LunaQu4kez/SUSTech_CS202_MineCPU/code/vivado_project/vivado_project.runs/progrom_synth_1/.vivado.begin.rst

<?xml version="1.0"?>
<ProcessHandle Version="1" Minor="0">
    <Process Command="vivado.bat" Owner="Kurumi" Host="LAPTOP-1890NNVV" Pid="9872">
    </Process>
</ProcessHandle>
