LunaQu4kez/SUSTech_CS202_MineCPU/program/testcase/testcase2.txt

0000000003af410113000000e30c0ffe83a581009304000063809504930410006388950693042000638e950e9304300063889516930440006384952093045000638e95229304600063849526930470006386952e6ff01ffb03a60100930200006308060013561600938212006ff05fff1303800063880200b302534023a651006ff05ff89302700023a651006ff09ff723a6010023a8010003a6010083a64100138306009373360093938300330373009373c60793d323001303034093070008337ef600930f9001b38e7f4063d40e02b38ef341331fd3016f00400063080e00330fe04123a4e1036ff0dff123a4e1036ff05ff1335fd301930f0002b38edf413313d301e30c03fc63080e00330fe04123a4e1036ff01fef130f1f0023a4e1036ff05fee23a6010023a8010003a6010083a64100138306009373360093938300330373009373c60793d323001303034093070008337ef600930f9001b38e7f4063d80e00b38ef341331fd3016ff01ff7335fd301930f0002b38edf413313d301e30e03f4630a0e00130f1f00330fe04123a4e1036ff01fe723a4e1036ff09fe623a6010023a8010003a6010083a64100138306009373360093938300330373009373c60793d323001303034093070008337ef600930f9001b38e7f4063d80e00b38ef341331fd3016ff05fef335fd301930f0002b384df4133149300e30004ee930f1000938efeffb39fdf013379f301938e1e00630409006f004001e30e0ef6330fe04123a4e1036ff0dfdde3060eee130f1f00330fe04123a4e1036ff09fdc23a6010023a8010003a6010083a641003303d60093538300130ef00f3373c30163860300330373006f0040003343c30123a6610023a461026ff0dfd823a6010023a8010003a6010083a641001303f000b373c30093968600b3837600371300001303f3ffb373730023a471026ff09fd523a6010023a8010003a60100130f0000930f000093850f00ef004001938f1f00e3cac5fe23a4e1036ff0dfd2130141ff232211002320b100130f2f0093a2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
