LunaQu4kez/SUSTech_CS202_MineCPU/program/testcase/testcase1.txt

00000000930e0000371e0010130e0e0003af4101e30edfff83a5810003a6010083a6410093040000638095049304100063829504930420006388950493043000638e95049304400063829506930450006386950693046000638a950693047000638e95066ff0dffa23a6c10023a8d1006ff01ffa0385010093083000730000002320ae006f00400703c5410093083000730000002322ae006f00000603230e0083234e00630473046f00000503230e0083234e00634c73026f00000403230e0083234e00635473026f00000303230e0083234e00636c73006f00000203230e0083234e00637473006f000001930f000c23a6f1016ff0dff1930f000023a6f1016ff01ff100000000000000000000000000000000000000000000000000000000000000000000000000000000000000000000000000000000000000000000000000000000000000000000000000000000000000000000000000000000000000000000000000000000000000000000000000000000000000000000000000000000000000000000000000000000000000000000000000000000000000000000000000000000000000000000000000000000000000000000000000000000000000000000000000000000000000000000000000000000000000000000000000000000000000000000000000000000000000000000000000000000000000000000000000000000000000000000000000000000000000000000000000000000000000000000000000000000000000000000000000000000000000000000000000000000000000000000000000000000000000000000000000000000000000000000000000000000000000000000000000000000000000000000000000000000000000000000000000000000000000000000000000000000000000000000000000000000000000000000000000000000000000000000000000000000000000000000000000000000000000000000000000000000000000000000000000000000000000000000000000000000000000000000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
