LunaQu4kez/SUSTech_CS202_MineCPU/sources/assembly/test_board/small_testcase.txt

00000000 13048000 93021000 03a54101
13000000 63045500 6ff05fff 03a40100
03a58101 13000000 63045500 6ff05fff
83a40100 03a5c101 13000000 63045500
6ff05fff 03a90100 13030000 63086400
13033000 630a6400 6ff0dffa 23a69100
23a82101 6ff01ffa 63862401 23a85100
6f008000 23a65100 6ff0dff8
