LunaQu4kez/SUSTech_CS202_MineCPU/sources/assembly/test_board/button_test.txt

00000000 93821200 03a34101 13000000
63846200 6ff05fff 83a30100 23a67100
6ff09ffe
