LunaQu4kez/SUSTech_CS202_MineCPU/program/my_pacman/main.cpp

#include <bits/stdc++.h>
using namespace std;

void init();
void print_map();
void time_delay();
void stepO();
void stepA();
void stepB();
void stepC();
void stepD();
bool checkover();
void ghost_move(int, int, int);
int bfs(int, int, int);


int game[31][28]; // -1 wall, 0 road, 1 point, 2 pacman, 3 red ghost, 4 pink ghost, 5 blue ghost, 6 orange ghost
int ox, oy;       // pacman x y
int gx[4], gy[4]; // ghost x y: red, pink, blue, orange
int dir;  // direction: 0 up, 1 down, 2 left, 3 right
int st[4];  // step now
int step, score;  
int cnt;  // for time delay
int bx[300], by[300], bh[300], bxt[300], byt[300], bht[300];  // t: temp, x,y: x,y, h: head
int bmap[31][28];
int bi, bit;  // bfs index
int wx, wy;


int main() {
    //while (true) {
        init();
        print_map();
        // if bt1 is pushed, start game
        // while (true) {
        //     if (bt1 is pushed) break;
        // }

        while (true) {
            ///******  for test  ******
            int t;
            cin >> t;
            if (t == 8) dir = 0;
            if (t == 5) dir = 1;
            if (t == 4) dir = 2;
            if (t == 6) dir = 3;
            // ******  for test  ******/
            time_delay();
            stepO();
            stepA();
            stepB();
            stepC();
            stepD();
            print_map();
            if (checkover()) {
                printf("*******************\n");
                printf("*******CAUGHT******\n");
                printf("*******************\n");
                break;
            }
        }

        // if bt1 is pushed, end and start a new game
        // while (true) {
        //     if (bt1 is pushed) break;
        // }
    //}
}

void stepO() {
    step++;
    printf("ox oy: %d %d\n", ox, oy);
    if (dir == 0) {   // up
        if (game[ox - 1][oy] != -1) {
            game[ox][oy] = 0;
            ox--;
            if (game[ox][oy] == 1) score++;
            game[ox][oy] = 2;
        }
    }
    if (dir == 1) {   // down
        if (game[ox + 1][oy] != -1) {
            game[ox][oy] = 0;
            ox++;
            if (game[ox][oy] == 1) score++;
            game[ox][oy] = 2;
        }
    }
    if (dir == 2) {   // left
        if (game[ox][oy - 1] != -1) {
            game[ox][oy] = 0;
            oy--;
            if (game[ox][oy] == 1) score++;
            game[ox][oy] = 2;
        }
    }
    if (dir == 3) {   // right
        if (game[ox][oy + 1] != -1) {
            game[ox][oy] = 0;
            oy++;
            if (game[ox][oy] == 1) score++;
            game[ox][oy] = 2;
        }
    }
}

void ghost_move(int idx, int tx, int ty) {   // ghost index, target point x, target point y
    printf("%d target %d %d\n", idx, tx, ty);
    printf("%d pos %d %d\n", idx, gx[idx], gy[idx]);
    printf("wx wy: %d %d\n", wx, wy);

    if (gx[idx] == tx && gy[idx] == ty) {
        game[tx][ty] = idx + 3;
        return;
    }

    cnt = 0;
    while (cnt < 300) {
        bxt[cnt] = 0;
        byt[cnt] = 0;
        bht[cnt] = 0;
        cnt++;
    }
    cnt = 0;
    int x = gx[idx];
    int y = gy[idx];
    for (int i = 0; i < 31; i++) {
        for (int j = 0; j < 28; j++) {
            bmap[i][j] = 0;
        }
    }
    bmap[x][y] = 1;
    if (idx == 1 || idx == 2) {
        bmap[wx][wy] = 1;
    }
    
    bit = 0;
    if (game[x-1][y] != -1 && bmap[x-1][y] != 1) {  // up
        if (x - 1 == tx && y == ty) {
            gx[idx] = tx;
            gy[idx] = ty;
            game[x][y] = st[idx];
            return;
        }
        bxt[bit] = x - 1;
        byt[bit] = y;
        bht[bit] = 0;
        bmap[x-1][y] = 1;
        bit++;
    }
    if (game[x+1][y] != -1 && bmap[x+1][y] != 1) {  // down
        if (x + 1 == tx && y == ty) {
            gx[idx] = tx;
            gy[idx] = ty;
            game[x][y] = st[idx];
            return;
        }
        bxt[bit] = x + 1;
        byt[bit] = y;
        bht[bit] = 1;
        bmap[x+1][y] = 1;
        bit++;
    }
    if (game[x][y-1] != -1 && bmap[x][y-1] != 1) {  // left
        if (x == tx && y - 1 == ty) {
            gx[idx] = tx;
            gy[idx] = ty;
            game[x][y] = st[idx];
            return;
        }
        bxt[bit] = x;
        byt[bit] = y - 1;
        bht[bit] = 2;
        bmap[x][y-1] = 1;
        bit++;
    }
    if (game[x][y+1] != -1 && bmap[x][y+1] != 1) {  // right
        if (x == tx && y + 1 == ty) {
            gx[idx] = tx;
            gy[idx] = ty;
            game[x][y] = st[idx];
            return;
        }
        bxt[bit] = x;
        byt[bit] = y + 1;
        bht[bit] = 3;
        bmap[x][y+1] = 1;
        bit++;
    }
    bit = 0;
    int d = bfs(idx, tx, ty);

    game[x][y] = st[idx];
    if (d == 0) {   // move up
        printf("%d move up\n", idx);
        x--;
        gx[idx]--;
    }
    if (d == 1) {   // move down
        printf("%d move down\n", idx);
        x++;
        gx[idx]++;
    }
    if (d == 2) {   // move left
        printf("%d move left\n", idx);
        y--;
        gy[idx]--;
    }
    if (d == 3) {   // move right
        printf("%d move right\n", idx);
        y++;
        gy[idx]++;
    }
    st[idx] = game[x][y];
    if (st[idx] == 2) st[idx] = 0;
    if (st[idx] == 3) st[idx] = st[0];
    if (st[idx] == 4) st[idx] = st[1];
    if (st[idx] == 5) st[idx] = st[2];
    if (st[idx] == 6) st[idx] = st[3];
    // game[x][y] = idx + 3;
}

int bfs(int idx, int tx, int ty) {
    cnt = 0;
    while (cnt < 300) {
        bx[cnt] = bxt[cnt];
        by[cnt] = byt[cnt];
        bh[cnt] = bht[cnt];
        cnt++;
    }
    cnt = 0;
    while (cnt < 300) {
        bxt[cnt] = 0;
        byt[cnt] = 0;
        bht[cnt] = 0;
        cnt++;
    }
    cnt = 0;
    bi = 0;
    bit = 0;

    int x = bx[bi];
    int y = by[bi];
    int h = bh[bi];
    while (x != 0 || y != 0) {
        if (game[x-1][y] != -1 && bmap[x-1][y] == 0) {  // up
            if (x - 1 == tx && y == ty) {
                if (idx == 0) {
                    wx = x;
                    wy = y;
                }
                return h;
            }
            bxt[bit] = x - 1;
            byt[bit] = y;
            bht[bit] = h;
            bmap[x-1][y] = 1;
            bit++;
        }
        if (game[x+1][y] != -1 && bmap[x+1][y] == 0) {  // down
            if (x + 1 == tx && y == ty) {
                if (idx == 0) {
                    wx = x;
                    wy = y;
                }
                return h;
            }
            bxt[bit] = x + 1;
            byt[bit] = y;
            bht[bit] = h;
            bmap[x+1][y] = 1;
            bit++;
        }
        if (game[x][y-1] != -1 && bmap[x][y-1] == 0) {  // left
            if (x == tx && y - 1 == ty) {
                if (idx == 0) {
                    wx = x;
                    wy = y;
                }
                return h;
            }
            bxt[bit] = x;
            byt[bit] = y - 1;
            bht[bit] = h;
            bmap[x][y-1] = 1;
            bit++;
        }
        if (game[x][y+1] != -1 && bmap[x][y+1] == 0) {  // right
            if (x == tx && y + 1 == ty) {
                if (idx == 0) {
                    wx = x;
                    wy = y;
                }
                return h;
            }
            bxt[bit] = x;
            byt[bit] = y + 1;
            bht[bit] = h;
            bmap[x][y+1] = 1;
            bit++;
        }
        bi++;
        x = bx[bi];
        y = by[bi];
        h = bh[bi];
    }
    return bfs(idx, tx, ty);
}

void stepA() {
    ghost_move(0, ox, oy);
}

void stepB() {
    int bx = gx[1];
    int by = gy[1];
    if(abs(bx - ox) + abs(by - oy) <= 2 && (bx != wx || by != wy)) {
        ghost_move(1, ox, oy);
        return;
    }
    if (dir == 0) {
        cnt = 2;
        while (cnt >= 0) {
            if (ox - cnt >= 0 && game[ox-cnt][oy] != -1 && bmap[ox-cnt][oy] != 1) {
                ghost_move(1, ox-cnt, oy);
                cnt = 0;
                break;
            }
            cnt--;
        }
    } 
    if (dir == 1) {
        cnt = 2;
        while (cnt >= 0) {
            if (ox + cnt < 31 && game[ox+cnt][oy] != -1 && bmap[ox+cnt][oy] != 1) {
                ghost_move(1, ox+cnt, oy);
                cnt = 0;
                break;
            }
            cnt--;
        }
    } 
    if (dir == 2) {
        cnt = 2;
        while (cnt >= 0) {
            if (oy - cnt >= 0 && game[ox][oy-cnt] != -1 && bmap[ox][oy-cnt] != 1) {
                ghost_move(1, ox, oy-cnt);
                cnt = 0;
                break;
            }
            cnt--;
        }
    } 
    if (dir == 3) {
        cnt = 2;
        while (cnt >= 0) {
            if (oy + cnt < 28 && game[ox][oy+cnt] != -1 && bmap[ox][oy+cnt] != 1) {
                ghost_move(1, ox, oy+cnt);
                cnt = 0;
                break;
            }
            cnt--;
        }
    } 
}

void stepC() {
    int px = 2*ox-gx[2];
    if (px < 0) px = 0;
    if (px >= 31) px = 30;
    int py = 2*oy-gy[2];
    if (py < 0) py = 0;
    if (py >= 28) py = 27;
    
    if (px > ox) {
        while (px >= ox) {
            if (game[px][py] != -1 && bmap[px][py] != 1) {
                ghost_move(2, px, py);
                return;
            }
            px--;
        }
    }
    if (px < ox) {
        while (px <= ox) {
            if (game[px][py] != -1 && bmap[px][py] != 1) {
                ghost_move(2, px, py);
                return;
            }
            px++;
        }
    }
    if (py > oy) {
        while (py >= oy) {
            if (game[px][py] != -1 && bmap[px][py] != 1) {
                ghost_move(2, px, py);
                return;
            }
            py--;
        }
    }
    if (py < oy) {
        while (py <= oy) {
            if (game[px][py] != -1 && bmap[px][py] != 1) {
                ghost_move(2, px, py);
                return;
            }
            py++;
        }
    }
}

void stepD() {
    int v = gx[3] - ox;
    int h = gy[3] - oy;
    if (abs(v) + abs(h) > 8) {
        ghost_move(3, ox, oy);
    } else {
        ghost_move(3, 29, 1);
    }
    game[ox][oy] = 2;
    game[gx[0]][gy[0]] = 3;
    game[gx[1]][gy[1]] = 4;
    game[gx[2]][gy[2]] = 5;
    game[gx[3]][gy[3]] = 6;
}


bool checkover() {
    if (score == 244) return true;
    if (ox == gx[0] && oy == gy[0]) return true;
    if (ox == gx[1] && oy == gy[1]) return true;
    if (ox == gx[2] && oy == gy[2]) return true;
    if (ox == gx[3] && oy == gy[3]) return true;
    return false;
}

void time_delay() {
    while (cnt < 10000000) {
        cnt++;
        // if (bt2 is pushed && dir != 1) dir = 0;
        // if (bt3 is pushed && dir != 0) dir = 1;
        // if (bt4 is pushed && dir != 3) dir = 2;
        // if (bt5 is pushed && dir != 2) dir = 3;
    }
    cnt = 0;
}

void print_map() {
    printf("   ");
    for (int j = 0; j < 28; j++) {
        if (j < 10) printf("%d ", j);
        else printf("%d", j);
    }
    printf("\n");
    for (int i = 0; i < 31; i++) {
        if (i < 10) printf("%d  ", i);
        else printf("%d ", i);
        for (int j = 0; j < 28; j++) {
            if (game[i][j] == -1) printf("X ");
            else if (game[i][j] == 0) printf("  ");
            else if (game[i][j] == 1) printf(". ");
            else if (game[i][j] == 2) printf("O ");
            else if (game[i][j] == 3) printf("A ");
            else if (game[i][j] == 4) printf("B ");
            else if (game[i][j] == 5) printf("C ");
            else if (game[i][j] == 6) printf("D ");
        }
        printf("\n");
    }
    printf("**********************************************************************************\n");
}

void init() {
    ox = 23;
    oy = 13;
    gx[0] = 17;
    gy[0] = 18;
    gx[1] = 11;
    gy[1] = 18;
    gx[2] = 17;
    gy[2] = 9;
    gx[3] = 11;
    gy[3] = 9;

    dir = 3;

    st[0] = 0;
    st[1] = 0;
    st[2] = 0;
    st[3] = 0;

    step = 0;
    score = 0;
    cnt = 0;
    bi = 0;
    bit = 0;

    game[0][0] = -1;
    game[0][1] = -1;
    game[0][2] = -1;
    game[0][3] = -1;
    game[0][4] = -1;
    game[0][5] = -1;
    game[0][6] = -1;
    game[0][7] = -1;
    game[0][8] = -1;
    game[0][9] = -1;
    game[0][10] = -1;
    game[0][11] = -1;
    game[0][12] = -1;
    game[0][13] = -1;
    game[0][14] = -1;
    game[0][15] = -1;
    game[0][16] = -1;
    game[0][17] = -1;
    game[0][18] = -1;
    game[0][19] = -1;
    game[0][20] = -1;
    game[0][21] = -1;
    game[0][22] = -1;
    game[0][23] = -1;
    game[0][24] = -1;
    game[0][25] = -1;
    game[0][26] = -1;
    game[0][27] = -1;

    game[1][0] = -1;
    game[1][1] = 1;
    game[1][2] = 1;
    game[1][3] = 1;
    game[1][4] = 1;
    game[1][5] = 1;
    game[1][6] = 1;
    game[1][7] = 1;
    game[1][8] = 1;
    game[1][9] = 1;
    game[1][10] = 1;
    game[1][11] = 1;
    game[1][12] = 1;
    game[1][13] = -1;
    game[1][14] = -1;
    game[1][15] = 1;
    game[1][16] = 1;
    game[1][17] = 1;
    game[1][18] = 1;
    game[1][19] = 1;
    game[1][20] = 1;
    game[1][21] = 1;
    game[1][22] = 1;
    game[1][23] = 1;
    game[1][24] = 1;
    game[1][25] = 1;
    game[1][26] = 1;
    game[1][27] = -1;

    game[2][0] = -1;
    game[2][1] = 1;
    game[2][2] = -1;
    game[2][3] = -1;
    game[2][4] = -1;
    game[2][5] = -1;
    game[2][6] = 1;
    game[2][7] = -1;
    game[2][8] = -1;
    game[2][9] = -1;
    game[2][10] = -1;
    game[2][11] = -1;
    game[2][12] = 1;
    game[2][13] = -1;
    game[2][14] = -1;
    game[2][15] = 1;
    game[2][16] = -1;
    game[2][17] = -1;
    game[2][18] = -1;
    game[2][19] = -1;
    game[2][20] = -1;
    game[2][21] = 1;
    game[2][22] = -1;
    game[2][23] = -1;
    game[2][24] = -1;
    game[2][25] = -1;
    game[2][26] = 1;
    game[2][27] = -1;

    game[3][0] = -1;
    game[3][1] = 1;
    game[3][2] = -1;
    game[3][3] = -1;
    game[3][4] = -1;
    game[3][5] = -1;
    game[3][6] = 1;
    game[3][7] = -1;
    game[3][8] = -1;
    game[3][9] = -1;
    game[3][10] = -1;
    game[3][11] = -1;
    game[3][12] = 1;
    game[3][13] = -1;
    game[3][14] = -1;
    game[3][15] = 1;
    game[3][16] = -1;
    game[3][17] = -1;
    game[3][18] = -1;
    game[3][19] = -1;
    game[3][20] = -1;
    game[3][21] = 1;
    game[3][22] = -1;
    game[3][23] = -1;
    game[3][24] = -1;
    game[3][25] = -1;
    game[3][26] = 1;
    game[3][27] = -1;

    game[4][0] = -1;
    game[4][1] = 1;
    game[4][2] = -1;
    game[4][3] = -1;
    game[4][4] = -1;
    game[4][5] = -1;
    game[4][6] = 1;
    game[4][7] = -1;
    game[4][8] = -1;
    game[4][9] = -1;
    game[4][10] = -1;
    game[4][11] = -1;
    game[4][12] = 1;
    game[4][13] = -1;
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
    game[30][21] = -1;
    game[30][22] = -1;
    game[30][23] = -1;
    game[30][24] = -1;
    game[30][25] = -1;
    game[30][26] = -1;
    game[30][27] = -1;

    game[ox][oy] = 2;
    game[gx[0]][gy[0]] = 3;
    game[gx[1]][gy[1]] = 4;
    game[gx[2]][gy[2]] = 5;
    game[gx[3]][gy[3]] = 6;
}
