LunaQu4kez/SUSTech_CS202_MineCPU/sources/constrain/constr.xdc

set_property IOSTANDARD LVCMOS33 [get_ports *]


set_property PACKAGE_PIN Y18 [get_ports clk]
set_property PACKAGE_PIN P20 [get_ports rst]
set_property PACKAGE_PIN Y19 [get_ports rx]
set_property PACKAGE_PIN Y9 [get_ports {switches1[7]}]
set_property PACKAGE_PIN W9 [get_ports {switches1[6]}]
set_property PACKAGE_PIN Y7 [get_ports {switches1[5]}]
set_property PACKAGE_PIN Y8 [get_ports {switches1[4]}]
set_property PACKAGE_PIN AB8 [get_ports {switches1[3]}]
set_property PACKAGE_PIN AA8 [get_ports {switches1[2]}]
set_property PACKAGE_PIN V8 [get_ports {switches1[1]}]
set_property PACKAGE_PIN V9 [get_ports {switches1[0]}]
set_property PACKAGE_PIN AB6 [get_ports {switches2[7]}]
set_property PACKAGE_PIN AB7 [get_ports {switches2[6]}]
set_property PACKAGE_PIN V7 [get_ports {switches2[5]}]
set_property PACKAGE_PIN AA6 [get_ports {switches2[4]}]
set_property PACKAGE_PIN Y6 [get_ports {switches2[3]}]
set_property PACKAGE_PIN T6 [get_ports {switches2[2]}]
set_property PACKAGE_PIN R6 [get_ports {switches2[1]}]
set_property PACKAGE_PIN V5 [get_ports {switches2[0]}]
set_property PACKAGE_PIN U6 [get_ports {switches3[7]}]
set_property PACKAGE_PIN W5 [get_ports {switches3[6]}]
set_property PACKAGE_PIN W6 [get_ports {switches3[5]}]
set_property PACKAGE_PIN U5 [get_ports {switches3[4]}]
set_property PACKAGE_PIN T5 [get_ports {switches3[3]}]
set_property PACKAGE_PIN T4 [get_ports {switches3[2]}]
set_property PACKAGE_PIN R4 [get_ports {switches3[1]}]
set_property PACKAGE_PIN W4 [get_ports {switches3[0]}]
set_property PACKAGE_PIN P4 [get_ports bt1]
set_property PACKAGE_PIN P5 [get_ports bt2]
set_property PACKAGE_PIN P2 [get_ports bt3]
set_property PACKAGE_PIN P1 [get_ports bt4]
set_property PACKAGE_PIN R1 [get_ports bt5]
set_property PACKAGE_PIN L5 [get_ports {kp[7]}]
set_property PACKAGE_PIN J6 [get_ports {kp[6]}]
set_property PACKAGE_PIN K6 [get_ports {kp[5]}]
set_property PACKAGE_PIN M2 [get_ports {kp[4]}]
set_property PACKAGE_PIN K3 [get_ports {kp[3]}]
set_property PACKAGE_PIN L3 [get_ports {kp[2]}]
set_property PACKAGE_PIN J4 [get_ports {kp[1]}]
set_property PACKAGE_PIN K4 [get_ports {kp[0]}]
set_property PACKAGE_PIN K17 [get_ports {led1_out[7]}]
set_property PACKAGE_PIN L13 [get_ports {led1_out[6]}]
set_property PACKAGE_PIN M13 [get_ports {led1_out[5]}]
set_property PACKAGE_PIN K14 [get_ports {led1_out[4]}]
set_property PACKAGE_PIN K13 [get_ports {led1_out[3]}]
set_property PACKAGE_PIN M20 [get_ports {led1_out[2]}]
set_property PACKAGE_PIN N20 [get_ports {led1_out[1]}]
set_property PACKAGE_PIN N19 [get_ports {led1_out[0]}]
set_property PACKAGE_PIN M17 [get_ports {led2_out[7]}]
set_property PACKAGE_PIN M16 [get_ports {led2_out[6]}]
set_property PACKAGE_PIN M15 [get_ports {led2_out[5]}]
set_property PACKAGE_PIN K16 [get_ports {led2_out[4]}]
set_property PACKAGE_PIN L16 [get_ports {led2_out[3]}]
set_property PACKAGE_PIN L15 [get_ports {led2_out[2]}]
set_property PACKAGE_PIN L14 [get_ports {led2_out[1]}]
set_property PACKAGE_PIN J17 [get_ports {led2_out[0]}]
set_property PACKAGE_PIN F21 [get_ports {led3_out[7]}]
set_property PACKAGE_PIN G22 [get_ports {led3_out[6]}]
set_property PACKAGE_PIN G21 [get_ports {led3_out[5]}]
set_property PACKAGE_PIN D21 [get_ports {led3_out[4]}]
set_property PACKAGE_PIN E21 [get_ports {led3_out[3]}]
set_property PACKAGE_PIN D22 [get_ports {led3_out[2]}]
set_property PACKAGE_PIN E22 [get_ports {led3_out[1]}]
set_property PACKAGE_PIN A21 [get_ports {led3_out[0]}]
set_property PACKAGE_PIN A18 [get_ports {seg_en[7]}]
set_property PACKAGE_PIN A20 [get_ports {seg_en[6]}]
set_property PACKAGE_PIN B20 [get_ports {seg_en[5]}]
set_property PACKAGE_PIN E18 [get_ports {seg_en[4]}]
set_property PACKAGE_PIN F18 [get_ports {seg_en[3]}]
set_property PACKAGE_PIN D19 [get_ports {seg_en[2]}]
set_property PACKAGE_PIN E19 [get_ports {seg_en[1]}]
set_property PACKAGE_PIN C19 [get_ports {seg_en[0]}]
set_property PACKAGE_PIN F15 [get_ports {seg_out[7]}]
set_property PACKAGE_PIN F13 [get_ports {seg_out[6]}]
set_property PACKAGE_PIN F14 [get_ports {seg_out[5]}]
set_property PACKAGE_PIN F16 [get_ports {seg_out[4]}]
set_property PACKAGE_PIN E17 [get_ports {seg_out[3]}]
set_property PACKAGE_PIN C14 [get_ports {seg_out[2]}]
set_property PACKAGE_PIN C15 [get_ports {seg_out[1]}]
set_property PACKAGE_PIN E13 [get_ports {seg_out[0]}]
set_property PACKAGE_PIN M21 [get_ports hsync]
set_property PACKAGE_PIN L21 [get_ports vsync]
set_property PACKAGE_PIN H15 [get_ports {red[3]}]
set_property PACKAGE_PIN J15 [get_ports {red[2]}]
set_property PACKAGE_PIN G18 [get_ports {red[1]}]
set_property PACKAGE_PIN G17 [get_ports {red[0]}]
set_property PACKAGE_PIN H22 [get_ports {green[3]}]
set_property PACKAGE_PIN J22 [get_ports {green[2]}]
set_property PACKAGE_PIN H18 [get_ports {green[1]}]
set_property PACKAGE_PIN H17 [get_ports {green[0]}]
set_property PACKAGE_PIN K22 [get_ports {blue[3]}]
set_property PACKAGE_PIN K21 [get_ports {blue[2]}]
set_property PACKAGE_PIN G20 [get_ports {blue[1]}]
set_property PACKAGE_PIN H20 [get_ports {blue[0]}]
