LunaQu4kez/SUSTech_CS202_MineCPU/sources/Top.sv

`include "Const.svh"

module Top (
    // clk -> cpuclk, memclk, vgaclk
    input                     clk, rst,
    // uart related
    input  logic              rx,
    // interact with devices
    input  logic [`SWCH_WID ] switches1, switches2, switches3,
    input  logic              bt1, bt2, bt3, bt4, bt5,
    input  logic [`KBPIN_WID] kp,
    output logic [`LED_WID  ] led1_out, led2_out, led3_out,
    output logic [`LED_WID  ] seg_en, seg_out,
    // vga interface
    output logic              hsync,              // line synchronization signal
    output logic              vsync,              // vertical synchronization signal
    output logic [`COLOR_WID] red,
    output logic [`COLOR_WID] green,
    output logic [`COLOR_WID] blue
);

    wire clk0, clk1, cpuclk, memclk, vgaclk;
    wire uart_done;
    wire [`DATA_WID] uart_data, uart_addr;
    wire [`VGA_ADDR] vga_addr;
    wire [`INFO_WID] char_out, color_out;
    wire [`DATA_WID] seg1_out, timer;
    wire [`KBCODE_WID] kb_idx;

    CPU_Clk cpu_clk_inst (       // 50MHz
        .clk,
        .clk0
    );

    assign cpuclk = uart_done ? clk0 : clk;
    assign memclk = uart_done ? clk0 : clk;

    VGAClkGen vga_clk_gen_inst (  // 40MHz
        .clk_in1(clk),
        .clk_out1(vgaclk)
    );

    wire [`DATA_WID] pc_t, inst_t;

    CPU cpu_inst(
        .cpuclk,
        .memclk,
        .rst_n(~rst),
        .uart_data,
        .uart_addr,
        .uart_done,
        //.uart_done(1'b1),
        .switches1,
        .switches2,
        .switches3,
        .bt1,
        .bt2,
        .bt3,
        .bt4,
        .bt5,
        .kb_idx,
        .led1_out,
        .led2_out,
        .led3_out,
        .seg1_out,
        .vga_addr,
        .char_out,
        .color_out,
        .pc_t,
        .inst_t
    );

    UART uart_inst(
        .clk,
        .rst,
        .rx,
        .data_out(uart_data),
        .addr_out(uart_addr),
        .done(uart_done)
    );

    wire [`DATA_WID] seg7data;
    assign seg7data = inst_t;

    Seg7Tube seg7tube_inst(
        .clk,
        .rst_n(~rst),
        .data_in(seg1_out),
        //.data_in(seg7data),
        .seg_en,
        .seg_out
    );

    VGA vga_inst(
        .clk(vgaclk),
        .vga_addr,
        .ch(char_out),
        .color(color_out),
        .hsync,
        .vsync,
        .red,
        .green,
        .blue
    );

    Keyboard keyboard_inst (
        .kp,
        .kb_idx
    );
    
endmodule
