LunaQu4kez/SUSTech_CS202_MineCPU/sources/io/UART.sv

`include "Const.svh"

module UART (
    input                    clk, rst, rx,
    // ports to memory
    output logic [`DATA_WID] data_out,
    output logic [`DATA_WID] addr_out,
    output logic             done
);

    reg       rx_done = 0;
    reg [7:0] rx_data = 0;

    Queue queue (
        .clk(clk),
        .rst(rst),
        .data_in(rx_data),
        .ready_in(rx_done),
        .data_out,
        .addr_out
    );

    // timeout detection
    reg [15:0] idle_cnt = 0;
    reg [9:0]  idle_cnt0 = 0;
    reg        received = 0;

    // filter unexpected noise
    reg rxd_t0 = 1, rxd_t1 = 1, rxd_t2 = 1;

    // detect start bit
    reg  en_state = 0;
    wire nedge;
    assign nedge = !rxd_t1 & rxd_t2;

    assign done = (addr_out >= `MAX_DATA) | (received & (idle_cnt == `MAX_IDLE));
    always_ff @(posedge clk) begin
        if (rst | en_state) begin
            idle_cnt0 <= 10'h0;
        end else begin
            idle_cnt0 <= (idle_cnt0 == `BPS_CNT - 1) ? 0 : idle_cnt0 + 1'b1;
        end
    end

    always_ff @(posedge clk) begin
        if (rst | en_state) begin
            idle_cnt <= 16'h0;
        end else if (idle_cnt == `MAX_IDLE) begin
            idle_cnt <= idle_cnt;
        end else begin
            idle_cnt <= (idle_cnt0 == `BPS_CNT - 1) ? idle_cnt + 1'b1 : idle_cnt;
        end
    end
    
    
    always_ff @(posedge clk) begin
        if (rst) begin
            rxd_t0 <= 1'b1;
            rxd_t1 <= 1'b1;
            rxd_t2 <= 1'b1;
        end else begin
            rxd_t0 <= rx;
            rxd_t1 <= rxd_t0;
            rxd_t2 <= rxd_t1;
        end
    end

    
    always_ff @(posedge clk) begin
        if (rst) en_state <= 1'b0;
        else if (nedge) en_state <= 1'b1;
        else if (rx_done) en_state <= 1'b0;
        else en_state <= en_state;
    end
    
    // count baud
    reg [9:0] baud_cnt;
    always_ff @(posedge clk) begin
        if (rst) baud_cnt <= 10'b0;
        else if (en_state) begin
            if(baud_cnt == `BPS_CNT - 1) baud_cnt <= 10'b0;
            else baud_cnt <= baud_cnt + 1'b1;
        end else baud_cnt <= 10'b0;
    end
    
    // count bits
    reg [3:0] bit_cnt;
    always_ff @(posedge clk) begin
        if (rst) bit_cnt <= 4'd0;
        else if (en_state) begin
            if(bit_cnt == 4'd0) bit_cnt <= bit_cnt + 1'b1;
            else if(baud_cnt == `BPS_CNT - 1) bit_cnt <= bit_cnt + 1'b1;
            else bit_cnt <= bit_cnt;
        end else bit_cnt <= 4'b0;
    end

    // receive data
    always_ff @(posedge clk) begin
        if (rst) begin
            rx_data <= 8'd0;
            received <= 1'b0;
        end else if (en_state) begin
            received <= 1'b1;
            case (bit_cnt)
                4'd1: rx_data[0] <= rxd_t2;
                4'd2: rx_data[1] <= rxd_t2;
                4'd3: rx_data[2] <= rxd_t2;
                4'd4: rx_data[3] <= rxd_t2;
                4'd5: rx_data[4] <= rxd_t2;
                4'd6: rx_data[5] <= rxd_t2;
                4'd7: rx_data[6] <= rxd_t2;
                4'd8: rx_data[7] <= rxd_t2;
             default: rx_data <= rx_data;
            endcase
        end else begin
            rx_data <= rx_data;
            received <= received;
        end
    end

    // receive done logic
    always_ff @(posedge clk) begin
        if (rst) begin
            rx_done <= 1'b0;
        end else if (en_state) begin
            if(bit_cnt == 0) rx_done <= 1'b0;
            else if(bit_cnt == 9 && baud_cnt == `BPS_CNT - 1) rx_done <= 1'b1;
            else if(rx_done == 1'b1) rx_done <= 1'b0;
            else rx_done <= rx_done;
        end else if(rx_done == 1'b1) rx_done <= 1'b0;
        else rx_done <= rx_done;
    end
        
endmodule
