LunaQu4kez/SUSTech_CS202_MineCPU/sources/io/CPU_Clk.sv

module CPU_Clk (
    input clk,
    output clk0
);

    reg [15:0] cnt = 0;
    reg t = 0;
    assign clk0 = t;

    always @(posedge clk) begin
        if (cnt == 50) begin
            cnt <= 0;
        end
        else begin
           cnt <= cnt + 1'b1; 
        end
    end

    always @(posedge clk) begin
        if (cnt == 50) begin
            t <= ~t;
        end 
    end
    
endmodule
