LunaQu4kez/SUSTech_CS202_MineCPU/sources/core/ALU.sv

`include "Const.svh"

module ALU (
    input  logic [`DATA_WID ] src1, src2,
    input  logic [`ALUOP_WID] ALU_op,
    output logic [`DATA_WID ] result
);

    logic [`MUL_WID] mul;

    always_comb begin
        unique case (ALU_op)
        `ALU_AND:  result = src1 & src2;
        `ALU_OR :  result = src1 | src2;
        `ALU_XOR:  result = src1 ^ src2;
        `ALU_ADD:  result = $signed(src1) + $signed(src2);
        `ALU_SUB:  result = $signed(src1) - $signed(src2);
        `ALU_SLL:  result = src1 << src2[4:0];
        `ALU_SRL:  result = src1 >> src2[4:0];
        `ALU_SRA:  result = $signed(src1) >>> src2[4:0];
        `ALU_SLT:  result = ($signed(src1) < $signed(src2)) ? 1 : 0;
       `ALU_SLTU:  result = ($unsigned(src1) < $unsigned(src2)) ? 1 : 0;
        `ALU_MUL:  result = mul[31:0];
       `ALU_MULH:  result = mul[63:32];
     `ALU_MULHSU:  result = mul[63:32];
      `ALU_MULHU:  result = mul[63:32];
        `ALU_DIV:  result = $signed(src1) / $signed(src2);
        `ALU_REM:  result = $signed(src1) % $signed(src2);
         default:  result = 0;
        endcase
    end

    always_comb begin
        unique case (ALU_op)
        `ALU_MUL:  mul = $signed(src1) * $signed(src2);
       `ALU_MULH:  mul = $signed(src1) * $signed(src2);
     `ALU_MULHSU:  mul = $signed(src1) * $unsigned(src2);
      `ALU_MULHU:  mul = $unsigned(src1) * $unsigned(src2);
         default:  mul = 64'h0000_0000_0000_0000;
        endcase
    end

endmodule
