LunaQu4kez/SUSTech_CS202_MineCPU/(commit log)

2024-03-29 update: add stages and finish ALU
2024-03-30 fix ImmGen and Seg7Tube
    [ImmGen.sv, Seg7Tube.sv]
2024-03-30 update: implement Stage EX (yet tested)
2024-03-30 fix: ALU and its simulation
    [ALU.sv, ALU_Sim.cpp]
2024-03-31 fix: Forward.sv and Stage_EX.sv
    [Forward.sv, Stage_EX.sv]
2024-03-31 update: add ctrl wires to stage regs
2024-04-01 update: Stage_Mem.sv
2024-04-01 fix: add some neccesary wire
    [Stage_EX.sv]
2024-04-01 update: simplify Stage_MEM.sv
2024-04-02 update: add IF_Flush (for control adventure) wire to IF_ID
2024-04-02 update: Stage_WB.sv
2024-04-02 update: Stage_ID and Stage_IF
2024-04-05 fix: add branch signal from EX
    [ALU.sv, BRU.sv]
2024-04-07 fix: change file name and fix a small bug
    [Memory.sv, MemoryAnalog.sv]
2024-04-07 fix: update 4 regs and 3 stages to newest design (except ID, ID_EX, EX)
    [EX_MEM.sv, IF_ID.sv, MEM_WB.sv, RegisterFile.sv, Stage_IF.sv, Stage_MEM.sv]
2024-04-07 fix: remove warning of memory
    [Memory.sv, MemoryAnalog.sv, Memory_Sim.cpp]
2024-04-08 update: Stage ID update
2024-04-09 fix: initial pc now can be zero
    [Branch_Predictor.sv, PC.sv]
2024-04-09 fix: wrong flush for IF_ID register
    [CPU.sv, IF_ID.sv]
2024-04-09 fix: warnings from verilator
    [BRU.sv, Branch_Predictor.sv, CPU.sv, Control.sv, EX_MEM.sv, ID_EX.sv, IF_ID.sv, MEM_WB.sv]
2024-04-09 fix: CPU simulation and rst signal
    [CPU.sv, CPU_Sim.cpp]
2024-04-10 fix: unexpected value in Branch Predictor state and Stack Pointer Base address
    [Branch_Predictor.sv, CPU_Sim.cpp]
2024-04-12 fix: PHT not updated correctly
    [Branch_Predictor.sv, CPU.sv, CPU_Sim.cpp]
2024-04-12 fix: reset function of branch predictor
    [Branch_Predictor.sv]
2024-04-18 fix: simulator files bug
    [CPU_Sim.cpp, DiffTest.cpp]
2024-04-18 fix: rename LDST, SEPC -> ldst, sepc
    [Branch_Predictor.sv, CPU.sv, CPU_Sim.sv, Control.sv, Memory.sv, MemoryAnalog.sv, Memory_Sim.cpp, Memory_Sim.sv]
2024-04-18 fix: interrupt process instructions
    [Memory.sv]
2024-04-19 update: uart module
2024-04-19 test: uart passed
2024-04-19 fix: change uart_done logic to detect whether the data received overflow or being idle for a while
    [UART.sv]
2024-04-19 fix: uart idle detection logic
    [UART.sv]
2024-04-19 update: pack cpu and uart in top module
2024-04-19 format: beautify and add comments to uart module
2024-04-19 format: beautify uart module
2024-04-19 test: modify test1 -> copy switches to led
2024-04-22 fix: initial value of RAS top pointer need to be -1
    [Branch_Predictor.sv]
2024-04-22 fix: typo in previous commit
    [Memory.sv, Seg7Tube.sv, Top.sv]
2024-04-22 fix: pin from cpu to vga
    [Top.sv]
2024-04-23 fix: RV32M conflict with RV32I
    [Control.sv]
2024-04-24 add: pacman cpp framework
2024-04-29 modify: UART constant
2024-04-29 fix: I$ stall logic
    [ICache.sv]
2024-05-02 fix: offset should cover [11:2] due to inst width
    [ICache.sv]
2024-05-02 fix: abnormal update of buffers due to stall
    [Branch_Predictor.sv, CPU.sv, Stage_ID.sv]
2024-05-04 fix: branch predictor conflict with icache
    [CPU.sv, Control.sv, EX_MEM.sv, ICache.sv, ID_EX.sv, IF_ID.sv, MEM_WB.sv, Memory.sv]
2024-05-04 fix: Cache stall logic (almost exhausted:(
    [Branch_Predictor.sv, CPU.sv, CPU_Sim.cpp, EX_MEM.sv, ICache.sv, ID_EX.sv, IF_ID.sv, MEM_WB.sv]
2024-05-04 fix: unmapped memory and CPU sim
    [CPU_Sim.cpp]
2024-05-04 fix: D$ incomptible with mmio
    [CPU_Sim.cpp, DCache.sv]
2024-05-06 fix: VGA color bit length
    [CPU.sv]
2024-05-06 fix: add customizablility to I$ and Branch Predictor
    [Branch_Predictor.sv, ICache.sv]
2024-05-06 fix: add customizability to D$
    [DCache.sv, ICache.sv, PC.sv]
2024-05-06 fix: segment tube
2024-05-06 modify: 7 seg tube addr
2024-05-06 add: UART test on board
2024-05-06 modify: UART board test pass
2024-05-06 fix: PC initial value
    [PC.sv]
2024-05-06 add: test board's led
2024-05-06 fix: change basic io to sequencial
    [Memory.sv, Seg7Tube.sv, Top_Sim.sv]
2024-05-06 test: UART board test
2024-05-06 add: UART tool
2024-05-06 fix: fix uart_done and add initial value of some signals
    [CPU.sv, Queue.sv, SlowClock.sv, Top.sv, UART.sv]
2024-05-07 fix: move branch predictor to IF
    [Branch_Predictor.sv, CPU.sv, Control.sv, ID_EX.sv, IF_ID.sv, Memory.sv, PC.sv, Stage_ID.sv]
2024-05-07 fix: stall I$ for three cycle to give predictor more time
    [ICache.sv, Memory.sv]
2024-05-07 fix: uart constant
2024-05-07 fix: EX stage Jalr signal
    [Stage_EX.sv]
2024-05-07 fix: ROM treated as cached caused abnormal ecall
    [ICache.sv]
2024-05-07 fix: ecall & sret
    [Branch_Predictor.sv, CPU.sv, ICache.sv, Memory.sv, PC.sv, Stage_IF.sv]
2024-05-07 test: improve test case 9
2024-05-07 debug: UART (not finish)
2024-05-07 revert: rm prefetch in I$
    This reverts commit d0bc9c93a7cf6c7f97eb3c8483172c6f1d7c82ca.
    [ICache.sv]
2024-05-07 fix: wrong write enable signal to mem
    [DCache.sv]
2024-05-07 debug: UART module
2024-05-07 debug: UART finish (f**k ip core)
2024-05-08 update: CPU with UART can run on board!
2024-05-09 fix: predict_fail logic and src of jalr
    [Branch_Predictor.sv, CPU_Sim.cpp, Control.sv]
2024-05-09 test: on board button test pass
2024-05-09 test: board test case pass
2024-05-10 feat: add timer and related driver
2024-05-10 fix: conflict varname against keyword
    [CPU.sv, Memory.sv, Top.sv]
2024-05-10 fix: Timer.sv
2024-05-10 fix: ecall timer get time
    [Memory.sv]
2024-05-10 modify: remove timer
2024-05-11 fix: wrong processing of lb/lbu/lh/lhu when accessing mmio
    [DCache.sv]
2024-05-11 fix: wrong update of old_cache and wrong write back action and improve test9 and remove wrong version of bitstream
    [CPU_Sim.cpp, DCache.sv]
2024-05-11 fix: testcase1 and ecall
    [DCache.sv, Memory.sv]
2024-05-12 modify: change mmio stall longer
    [CPU.sv, DCache.sv, Memory.sv]
2024-05-12 revert: too many bugs 🤬🤯
    [CPU_Sim.sv, DCache.sv, Memory.sv]
2024-05-12 fix: wrong func7 of rv32m
    [Control.sv]
2024-05-12 modify: change testcase1 buttons' location
2024-05-12 fix: inconsistency in regs and cache
    [DCache.sv, ID_EX.sv, IF_ID.sv, Stage_IF.sv]
2024-05-14 update: pacman init and print_map
2024-05-15 fix: wrong constraint of button
    [constr.xdc]
2024-05-19 update： Report
